Jshulgach/WALL-E-Jr/doc/bom.xlsx

Part | Unit Cost | Link
Servo | $6 | https://www.amazon.com/4-Pack-MG996R-Torque-Digital-Helicopter/dp/B07MFK266B
Wires | $7 | https://www.amazon.com/Elegoo-EL-CP-004-Multicolored-Breadboard-arduino/dp/B01EV70C78
Resistors | $1 | https://www.amazon.com/MCIGICM-Values-Resistor-Assortment-Resistors/dp/B06WRQS97C
Arduino UNO | $13 | https://www.amazon.com/KEYESTUDIO-Development-Board-ATmega328P-Arduino/dp/B08H1RB61B
5mm Color LED | $12 | https://www.amazon.com/DiCUNO-450pcs-Colors-Emitting-Assorted/dp/B073QMYKDM
Buzzer | $8 | https://www.amazon.com/QMseller-Terminals-Raspberry-Electronic-Continous/dp/B07VRK7ZPF
Ultrasonic Sensor | $2 | https://www.amazon.com/CUQI-Ultrasonic-Measuring-Transmitter-Compatible/dp/B092D2DS1Y
Push button | $0.50 | https://www.amazon.com/Momentary-Tactile-Through-Breadboard-Friendly/dp/B07WF76VHT
IR Sensor | $2 | https://www.amazon.com/WWZMDiB-TCRT5000-Reflective-Photoelectric-Avoidance/dp/B0BDDBM2TR
4 AA batteries | $5 | https://www.amazon.com/Duracell-MN1500B4Z-CopperTop-Batteries-Technology/dp/B000YHO5MI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
AA Battery Case | $3 | https://www.amazon.com/Aobao-Battery-Holder-Leads-Wires/dp/B09MZ1VFVY
Tamiya Track and Wheel Set | $13 | https://www.amazon.com/Tamiya-Track-Wheel-Set-70100/dp/B001VZJDY2
Breadboard | $2 | https://www.amazon.com/Pcs-MCIGICM-Points-Solderless-Breadboard/dp/B07PCJP9DY
Basswood | $15 | https://www.amazon.com/Hammont-Basswood-Sheets-12x8x1-Pack/dp/B09NWBMDNL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
