Jshulgach/WALL-E-Jr/(commit log)

2023-04-07 project files and documentation
    [bom.xlsx]
2023-04-07 updated the bom to include the tread kit
    [bom.xlsx]
