Jshulgach/WALL-E-Jr/(notices)

Notices in the files:
README.md:
License: MIT
